joachimsh91/Closed-loop-DC-motor-with-PID-control/README.md

See Project report.pdf for all the details about this project.
